ohguma/analog_gyro_2022/(commit log)

2023-01-03 feat:初回公開
2023-01-21 Update README.md
    パーツリスト情報追加
